asandova-ui/fpga-lora-telemetry-node/SC/antena meandros/AntenaMeandros.aedtresults/Aproximacion1/DV483_S323_V482/SolverUsage_FS1.txt

    VersionID HFSS2016
    Success 1
    SolverName IESolver
    IterativeSolver 0
    DistributedSolver 0
    Precision 2
    NumTasks 1
    NumUnknowns 2215
    BasisOrder 0
    TREECOTREE 0
    MemoryMasterMB 323.101563
    MemoryTotalMB 323.101563
