asandova-ui/fpga-lora-telemetry-node/SC/antena meandros/AntenaMeandros.aedtresults/Aproximacion2/DV31_S30_V47/solverUsagefile.txt

    VersionID HFSS2016
    Success 1
    SolverName IESolver
    IterativeSolver 0
    DistributedSolver 0
    Precision 2
    NumTasks 1
    NumUnknowns 2128
    BasisOrder 0
    TREECOTREE 0
    MemoryMasterMB 308.519531
    MemoryTotalMB 308.519531
