asandova-ui/fpga-lora-telemetry-node/SC/antena meandros/AntenaMeandros.aedtresults/Aproximacion3/DV89_S8_V94/SolverUsage_FS1.txt

    VersionID HFSS2016
    Success 1
    SolverName IESolver
    IterativeSolver 0
    DistributedSolver 0
    Precision 2
    NumTasks 1
    NumUnknowns 2140
    BasisOrder 0
    TREECOTREE 0
    MemoryMasterMB 309.906250
    MemoryTotalMB 309.906250
