asandova-ui/fpga-lora-telemetry-node/SC/antena meandros/AntenaMeandros.aedtresults/Aproximacion4/DV95_S8_V108/SolverUsage_FS1.txt

    VersionID HFSS2016
    Success 1
    SolverName IESolver
    IterativeSolver 0
    DistributedSolver 0
    Precision 2
    NumTasks 1
    NumUnknowns 2137
    BasisOrder 0
    TREECOTREE 0
    MemoryMasterMB 309.625000
    MemoryTotalMB 309.625000
