asandova-ui/fpga-lora-telemetry-node/SC/antena meandros/AntenaMeandros.aedtresults/Aproximacion5/DV29_S8_V107/SolverUsage_FS1.txt

    VersionID HFSS2016
    Success 1
    SolverName IESolver
    IterativeSolver 0
    DistributedSolver 0
    Precision 2
    NumTasks 1
    NumUnknowns 3481
    BasisOrder 0
    TREECOTREE 0
    MemoryMasterMB 351.421875
    MemoryTotalMB 351.421875
