asandova-ui/fpga-lora-telemetry-node/SC/antena meandros/AntenaMeandros.aedtresults/Aproximacion6/DV89_S124_V0/SolverUsage_FS1.txt

    VersionID HFSS2016
    Success 1
    SolverName IESolver
    IterativeSolver 0
    DistributedSolver 0
    Precision 2
    NumTasks 1
    NumUnknowns 3582
    BasisOrder 0
    TREECOTREE 0
    MemoryMasterMB 348.253906
    MemoryTotalMB 348.253906
